TechAUmNu/A200S/README.md

# A200S - 16s 200A
A200S ESC - Based upon the VESC®*-Project
VESC is a registered TM, owned by Benjamin Vedder 

More info here: https://vesc-project.com/node/339
* 18 FET design
* 75v maximum 
* 200A continuous for about 2 minutes
* 300A burst for about 20s
