TechAUmNu/A200S/A200S V1.2 BOM.xlsx

Designator | Manufacturer | MPN | Mouser Part number | Part Name | Value | Package | Qty | Link
 |  |  |  | ICs
U5_1, U5_2, U5_3 | Texas Instruments | UCC27211DDAR | 595-UCC27211DDAR | 4A Gate Drivers |  | HSOP-8 | 3 | http://www.mouser.co.uk/ProductDetail/Texas-Instruments/UCC27211DDAR/
Q1_1, Q1_2, Q1_3, Q2_1, Q2_2, Q2_3, Q3_1, Q3_2, Q3_3, Q4_1, Q4_2, Q4_3, Q5_1, Q5_2, Q5_3, Q6_1, Q6_2, Q6_3 | Infineon | IPT015N10N5ATMA1 | 726-IPT015N10N5ATMA1 | Infineon Mosfets | 100v 300A | HSOF-8 | 18 | https://www.mouser.co.uk/ProductDetail/Infineon-Technologies/IPT015N10N5ATMA1
U7_1, U7_2, U7_3 | Texas Instruments | INA240A1PW | 595-INA240A1PW | current shunt amp |  | TSSOP-8 | 3 | https://www.mouser.co.uk/ProductDetail/Texas-Instruments/INA240A1PW/
U1 | Texas Instruments | SN65HVD232DG4 | 595-SN65HVD232DG4 | CANBUS trans |  | SOIC-8 | 1 | http://www.mouser.co.uk/ProductDetail/Texas-Instruments/SN65HVD232DG4/
OSC1 | Abracon | ASEMB-8.000MHZ-LY-T | 815-ASEMB-8-LY-T | 8mhz |  | 3.5x2.5x0.85mm | 1 | http://www.mouser.co.uk/ProductDetail/ABRACON/ASEMB-8000MHZ-LY-T/
U2, U4 | Diodes Incorporated | ZXTR2012K-13 | 621-ZXTR2012K-13 | 12v regulator |  | TO-252-3L | 2 | http://www.mouser.co.uk/ProductDetail/Diodes-Incorporated/ZXTR2012K-13/
U3 | Diodes Incorporated | Generic | 621-AZ1117IH-3.3TRG1 | 3.3v regulator |  | SOT-223-3 | 1 | https://www.mouser.co.uk/productdetail/diodes-incorporated/az1117ih-33trg1
U6 | STMicroelectronics | STM32F405RGT6 | 511-STM32F405RGT6 | Cortex M4 |  | LQFP-64 | 1 | http://www.mouser.co.uk/ProductDetail/STMicroelectronics/STM32F405RGT6/?qs=sGAEpiMZZMv%2fbGM7XKYHKw08UF8YuIh3
 |  |  |  | Diodes
D1 | Bourns | SMBJ5.0A | 652-SMBJ5.0A | TVS 5v 600w | 5v 600w | DO-214AA | 1 | http://www.mouser.co.uk/ProductDetail/Bourns/SMBJ50A/
D2 | Kingbright | APTD2012LSURCK | 604-APTD2012LSURCK | Red led | Red 630nm | 805 | 1 | https://www.mouser.co.uk/productdetail/kingbright/aptd2012lsurck
D3 | Kingbright | APTD2012LCGCK | 604-APTD2012LCGCK | Green led | Green 570nm | 805 | 1 | https://www.mouser.co.uk/productdetail/kingbright/aptd2012lcgck
D4 | Kingbright | APTD2012LQBCD | 604-APTD2012LQBCD | Blue led | Blue 465nm | 805 | 1 | https://www.mouser.co.uk/productdetail/kingbright/aptd2012lqbc-d
 |  |  |  | Capacitors
C14_1, C14_2, C14_3, C34_1, C34_2, C34_3, C35_1, C35_2, C35_3, C36_1, C36_2, C36_3, C37_1, C37_2, C37_3, C38_1, C38_2, C38_3, C39_1, C39_2, C39_3, C47, C48 | Murata | 81-GRJ32DC72A475KE1L | 81-GRJ32DC72A475KE1L | 4u7 100v ceramic | 4.7uF 100V | 1210 | 23 | https://www.mouser.co.uk/ProductDetail/Murata-Electronics/GRJ32DC72A475KE11L
C1, C3, C4, C7, C12, C21, C22, C23, C24, C25, C26, C27, C28, C29, C30, C31, C33_1, C33_2, C33_3, C46 | Kemet | C0805C225K8RACTU | 80-C0805C225K8R | 2u2 10v ceramic | 2.2uF 10v | 805 | 20 | https://www.mouser.co.uk/ProductDetail/80-C0805C225K8R
C13_1, C13_2, C13_3 | Taiyo Yuden | TMK325BJ475KN-T | 963-TMK325BJ475KN-T | 4u7 25v ceramic | 4.7uF 25v | 1210 | 3 | https://www.mouser.co.uk/ProductDetail/Taiyo-Yuden/TMK325BJ475KN-T
C2 | Vishay | TR3D476K025C0150 | 74-TR3D476K025C0150 | 47u 25v Tantalum | 47uF 25v | D Case | 1 | https://www.mouser.co.uk/ProductDetail/Vishay-Sprague/TR3D476K025C0150/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
C5, C6, C8, C9, C10, C11 | United Chemi-Con | EKZN101ELL102MM40S | 661-EKZN101E102MM40S | 1000u 100v Electrolitic | 1000uF 100v | 18x40 | 6 | https://www.mouser.co.uk/ProductDetail/United-Chemi-Con/EKZN101ELL102MM40S/
 |  |  |  | Resistors
R27_1, R27_2, R27_3, R28_1, R28_2, R28_3 | Vishay | WSLF2512L3000FEA | 71-WSLF2512L3000FEA | 0.3mOhm current shunt | 0.3mOhm | 2512 | 6 | https://www.mouser.co.uk/productdetail/vishay-dale/wslf2512l3000fea
R4, R5, R12_1 R12_2, R12_3, R13_1, R13_2, R13_3, R14_1, R14_2, R14_3, R15_1, R15_2, R15_3, R16_1, R16_2, R16_3, R17_1, R17_2, R17_3 | Yageo | RC0805FR-0722RL | 603-RC0805FR-0722RL | 22R | 22 Ohm 1% | 805 | 20 | https://www.mouser.co.uk/productdetail/yageo/rc0805fr-0722rl?qs=sGAEpiMZZMvdGkrng054t6dxHNVVMN7P4hCJbyGHQ5s%3D
R1, R6 | Yageo | RC0805FR-07100RL | 603-RC0805FR-07100RL | 100R | 100 Ohm 1% | 805 | 2 | http://www.mouser.co.uk/ProductDetail/Yageo/RC0805FR-07100RL/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
R7 | Yageo | RC0805FR-07820RL | 603-RC0805FR-07820RL | 820R | 820 Ohm 1% | 805 | 1 | https://www.mouser.co.uk/productdetail/yageo/rc0805fr-07820rl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
R8, R9 | Yageo | RC0805FR-07330RL | 603-RC0805FR-07330RL | 330R | 330 Ohm 1% | 805 | 2 | https://www.mouser.co.uk/productdetail/yageo/rc0805fr-07330rl
R3, R19, R20, R21, R26_1, R26_2, R26_3 | Yageo | RC0805JR-072K2L | 603-RC0805JR-072K2L | 2k2 | 2.2k Ohm 1% | 805 | 7 | http://www.mouser.co.uk/ProductDetail/Yageo/RC0805JR-072K2L/?qs=sGAEpiMZZMu61qfTUdNhG5eFuApKbqVdok4yO6QPrcE%3d
R10 | Murata | NCP21XV103J03RA | 81-NCP21XV103J03RA | 10k NTC | 10k 5% 3900K | 805 | 1 | https://www.mouser.co.uk/ProductDetail/Murata-Electronics/NCP21XV103J03RA
R11, R18 | Yageo | RC0805FR-0710KL | 603-RC0805FR-0710KL | 10k | 10k Ohm 1% | 805 | 2 | http://www.mouser.co.uk/ProductDetail/Yageo/RC0805FR-0710KL/?qs=sGAEpiMZZMu61qfTUdNhG0IfGdGRhTL5bSA8zzYr4w0%3d
R2, R25_1, R25_2, R25_3 | Yageo | RC0805FR-0768KL | 603-RC0805FR-0768KL | 68k | 68k Ohm 1% | 805 | 4 | http://www.mouser.co.uk/ProductDetail/Yageo/RC0805FR-0768KL/
 |  |  |  | Connectors
DBG | Samtec | CLP-105-02-F-D |  |  | Debug connector |  | 1 | https://www.digikey.co.uk/product-detail/en/samtec-inc/CLP-105-02-F-D/SAM1153-05-ND/1109830
K1 | Harwin | M20-9990346 | 855-M20-9990346 | SERVO | 3pin 2.54mm header |  | 1 | http://www.mouser.co.uk/ProductDetail/Harwin/M20-9990346/
P4 | Japan Solderless Terminals | B7B-PH-K-S(LF)(SN) |  | PWR_CONN | 7pos JST PH 2mm |  | 1 | https://www.digikey.co.uk/product-detail/en/jst-sales-america-inc/B7B-PH-K-S-LF-SN/455-1709-ND/926616
P3 | Japan Solderless Terminals | B6B-PH-K-S(LF)(SN) |  | HALL conn | 6pos JST PH 2mm |  | 1 | https://www.digikey.co.uk/products/en?keywords=%09B6B-PH-K-S(LF)(SN)
P2 | Japan Solderless Terminals | B4B-PH-K-S(LF)(SN) |  | CANBUS conn | 4pos JST PH 2mm |  | 1 | https://www.digikey.co.uk/products/en?keywords=B4B-PH-K-S(LF)(SN)
P1 | FCI / Amphenol | 10104111-0001LF | 649-10104111-0001LF | USB | Micro USB B |  | 1 | https://www.mouser.co.uk/ProductDetail/Amphenol-FCI/10104111-0001LF
