TechAUmNu/A200S/A200S V1.3.4 Heatsink.step

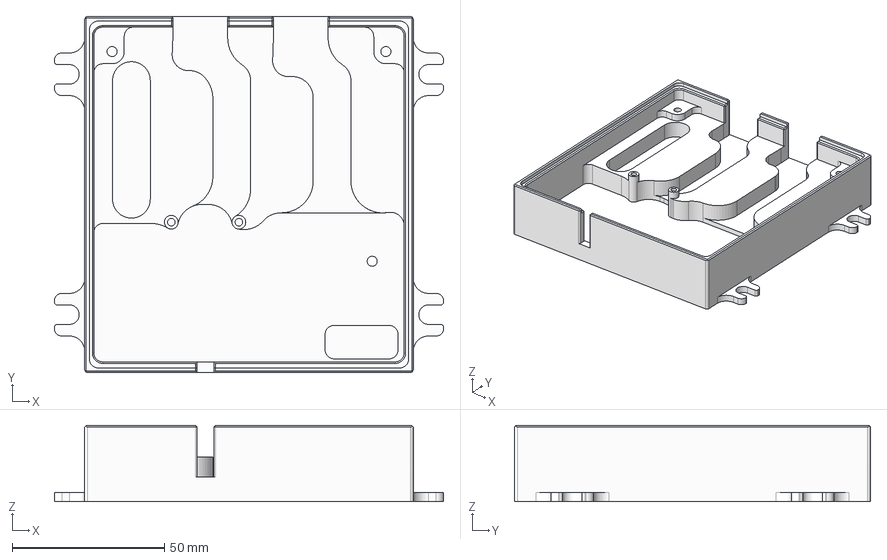
[picture p1: CAD file, 2019-01-06]
A200S V1.3.4 Heatsink.step
128.0 x 117.0 x 25.0 mm
