TechAUmNu/A200S/A200S V1.2 Simple.step

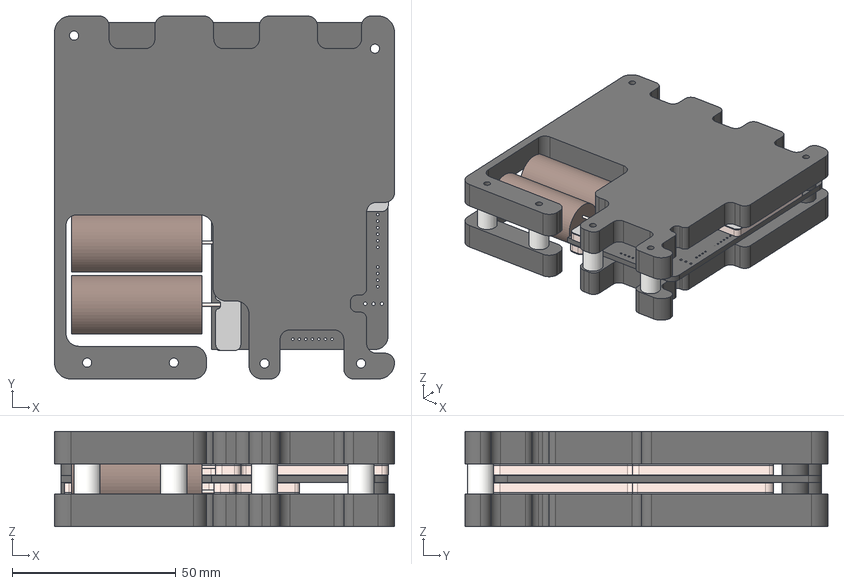
[picture p2: CAD file, 2018-05-13]
A200S V1.2 Simple.step
104.0 x 111.0 x 29.1 mm
Board
1000uF 100v cap v4
1000uF 100v cap v4 (1)
Bottom (2) x 2
93657A006_NYLON UNTHREADED SPACER v3
93657A006_NYLON UNTHREADED SPACER v3 (1)
93657A006_NYLON UNTHREADED SPACER v3 (2)
93657A006_NYLON UNTHREADED SPACER v3 (3)
93657A012_NYLON UNTHREADED SPACER v5
93657A012_NYLON UNTHREADED SPACER v5 (1)
93657A012_NYLON UNTHREADED SPACER v5 (2)
93657A012_NYLON UNTHREADED SPACER v5 (3)
