TechAUmNu/A200S/(list of files, cad)

Other CAD files:
Bottom Copper 3mm.dwg
Top Copper 3mm.dwg
