TechAUmNu/A200S/A200S V1.2 Schematic.PDF

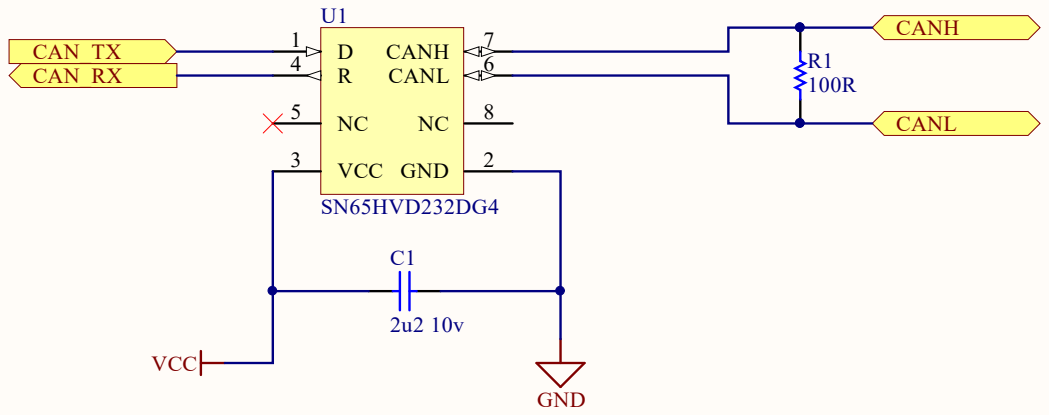
[picture p3: page 1]
Date:; Sheet of; File:; CAN Transceiver.SchDoc; Drawn By:; GND; 2 VCC 3; CANL; 6 CANH

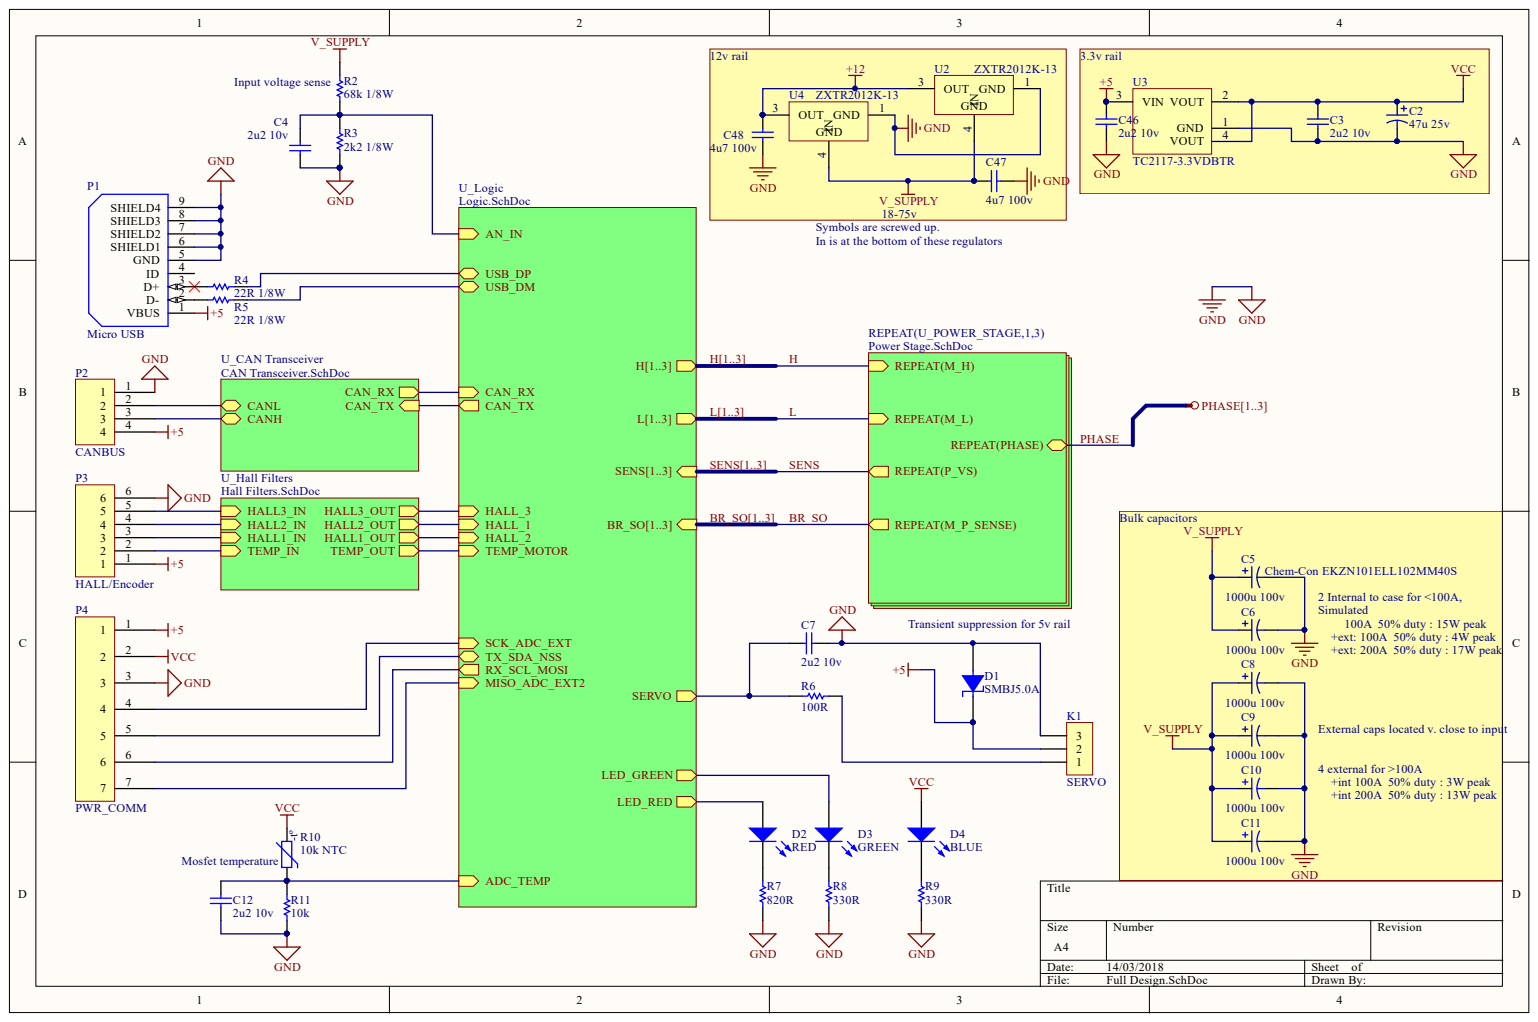
[picture p4: page 2]

Symbols are screwed up.
In is at the bottom of these regulators

2 Internal to case for <100A,
Simulated
100A 50% duty : 15W peak
+ext: 100A 50% duty : 4W peak
+ext: 200A 50% duty : 17W peak

Transient suppression for 5v rail

External caps located v. close to input

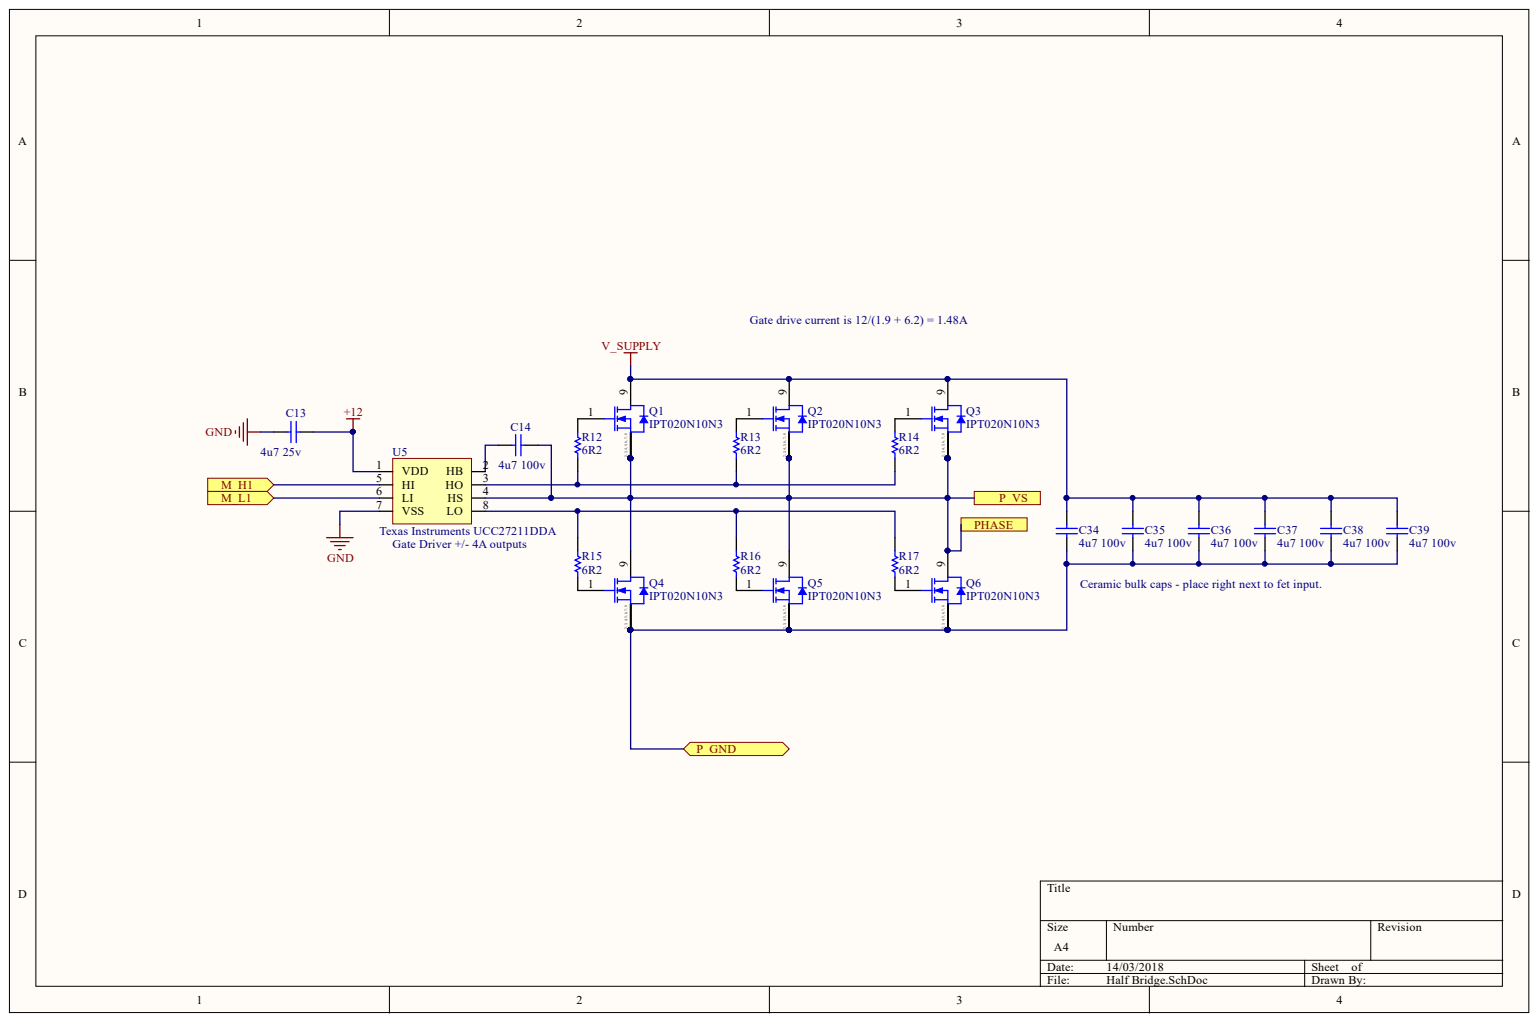
[picture p5: page 3]

Gate drive current is 12/(1.9 + 6.2) = 1.48A

Ceramic bulk caps - place right next to fet input.

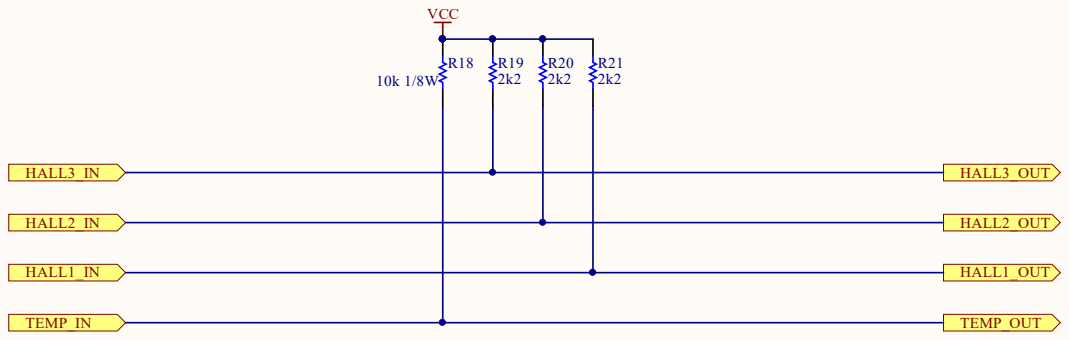
[picture p6: page 4]
File:; Hall Filters.SchDoc; Drawn By:

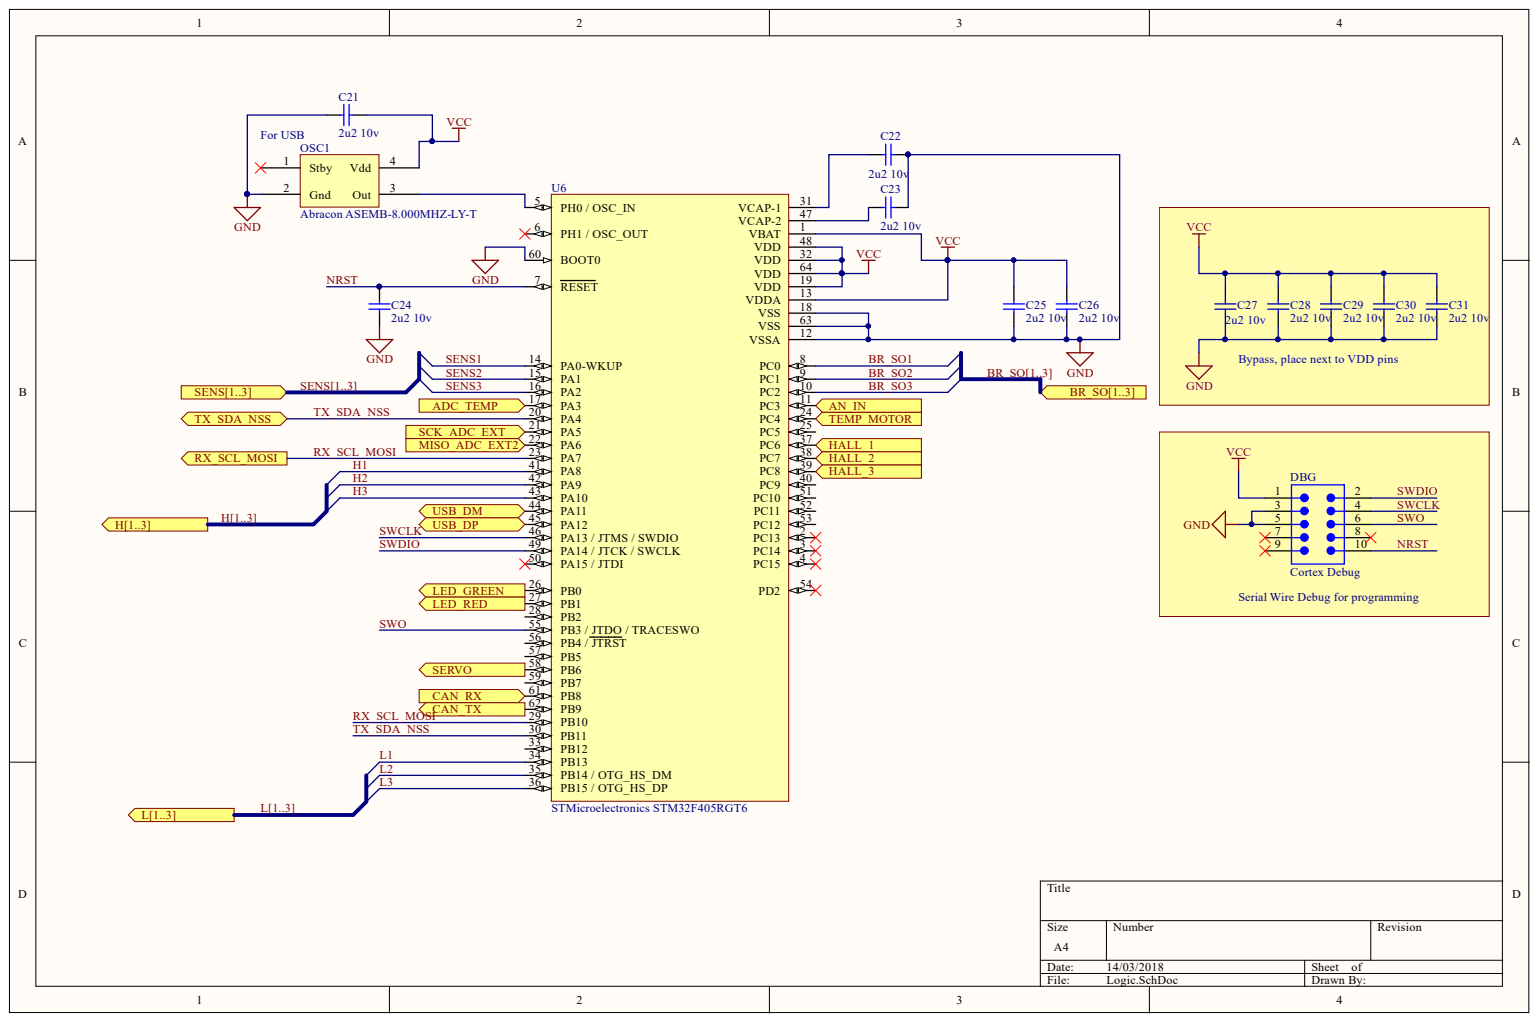
[picture p7: page 5]

BOOT0 60 RESET 7 | VCC

VCC

Bypass, place next to VDD pins

Serial Wire Debug for programming

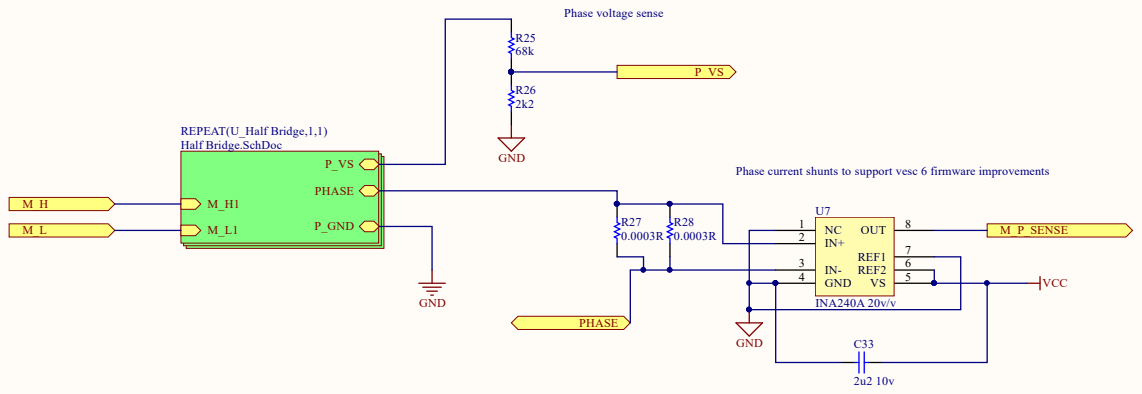
[picture p8: page 6]
File:; Power Stage.SchDoc; Drawn By:; GND 4; 5 REF2; 6 REF1; INA240A 20v/v

Phase voltage sense

REPEAT(U_Half Bridge,1,1)
Half Bridge.SchDoc

Phase current shunts to support vesc 6 firmware improvements
