TechAUmNu/A200S/(threads)

Thread 1 (2018-03-29):

Add +5v regulator onboard

aurimasniekis, 2018-03-29:
Hi, I just noticed that +5V rail regulator is missing in schematic

TechAUmNu, 2018-03-29:
I mean its not exactly efficient for power but when its already dissipating 80W who cares about another 1 or 2 watts! 😃 Plus it saves cost, board space and reduces the component count a bunch.

TechAUmNu, 2018-07-06:
V1.3 has DC-DC for 9-30v input.

Closed 2018-07-06.

Thread 2 (2018-05-03):

SWDIO and SWCLK swapped A200S V1.2

TechAUmNu, 2018-05-03:
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

To let anyone programming a board know that the SWDIO and SWCLK pins are swapped on the debug connector.

TechAUmNu, 2018-07-06:
Fixed on V1.3

Closed 2018-07-06.

Thread 3 (2018-11-08):

TX and RX lines swapped on External Com connector.

TechAUmNu, 2018-11-08:

TechAUmNu, 2018-11-08:
Fixed in V1.3.4
