TechAUmNu/A200S/(commit log)

2018-05-13 Add 3d model
    [A200S V1.2 Simple.step]
2018-07-06 Adding new bom and copper drawings
    [A200S V1.2 BOM.xlsx, Bottom Copper 3mm.dwg, Top Copper 3mm.dwg]
2018-07-06 removing old bom
    [A200S V1.2 BOM.xls]
2018-08-03 Add V1.2 heatsink drawing
    [A200S-001 (Heatsink V3) (1).dwg]
